wottle/lisa-mouse-logitech-m185/README.md

# Lisa Mouse — Logitech M185 conversion

A 3D-printed shell that turns a **Logitech M185** wireless mouse into a replica of the
**Apple Lisa mouse**. The M185's guts (PCB, sensor, switches, scroll wheel, battery) are
reused; the printed parts replace the stock case. Unlike the original one-button Lisa
mouse, this one has **two buttons**.

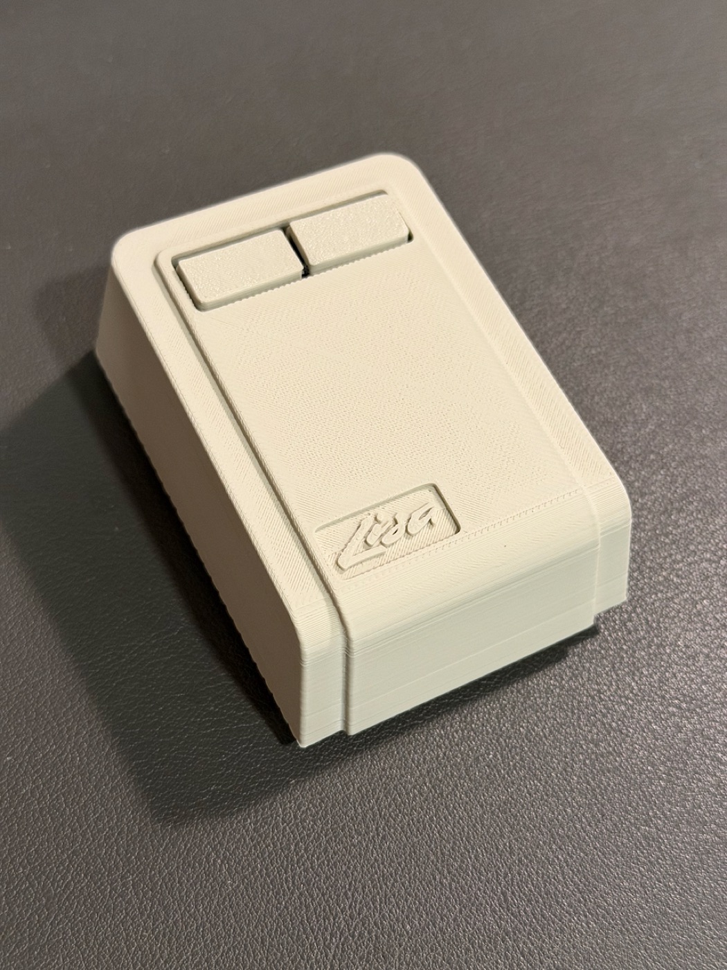
[picture p1: images/assembly/18a_assembly_complete_lisa_logo.jpg]
The finished Lisa Mouse, Lisa logo version


## What you need

| Item | Notes |
|---|---|
| **Genuine** Logitech M185 wireless mouse | Donor for the electronics. See the warning below. |
| 3D printer + PLA | Parts fit a 0.4 mm nozzle; see [docs/PRINTING.md](docs/PRINTING.md). |
| Small Phillips screwdriver | For the M185's own screws. |
| 1 × AA battery | Alkaline AA. |
| PTFE mouse slides (optional) | Self-adhesive pads on the underside for smoother gliding; use any you like. |
| M3 screws | 1 × M3×4 flat head (PCB), 2 × M3×6 countersunk (button retainer), 2 × M3×8 countersunk (case); see [docs/ASSEMBLY.md](docs/ASSEMBLY.md). |

> **⚠️ Buy a genuine Logitech M185.** Discount marketplaces (Temu, AliExpress and the like)
> sell knock-off mice made to look like the M185 but with a cheap, incompatible PCB inside.
> The printed parts are designed around the real M185 board and will not work with it.
> Buy from the Amazon Logitech store (or another authorized Logitech seller). Saving a few
> dollars isn't worth ending up with a mouse you can't use.

## Printed parts

STL files are in [`models/`](models/). Dimensions are the bounding box in the model's
design orientation (X × Y × Z, mm).

| File | Qty | Size (mm) | Purpose |
|---|:---:|---|---|
| `base.stl` | 1 | 57.7 × 84.8 × 18.1 | Bottom plate; holds the M185 board and battery. |
| `top_shell.stl` **or** `top_shell_lisa_logo.stl` | 1 | 62.2 × 91.7 × 31.1 | The Lisa-style upper shell. The `_lisa_logo` variant has an embossed "Lisa" wordmark on top; the plain one is smooth (the photos also show it with an Apple logo decal). |
| `left_button.stl` | 1 | 20.1 × 27.1 × 23.9 | Left button. |
| `right_button.stl` | 1 | 23.9 × 27.1 × 19.5 | Right button. |
| `button_stop.stl` | 1 | 35.6 × 16.1 × 3.9 | Retainer plate that holds both buttons in the top shell. |
| `on_off_button.stl` | 1* | 12.0 × 7.2 × 6.0 | Power switch actuator, slides in the base to operate the M185 power switch. |
| `battery_cover_1.stl` | 1 | 14.7 × 53.1 × 8.9 | Battery door (main plate). |
| `battery_cover_2.stl` | 1 | 7.5 × 11.8 × 6.2 | Battery door (latch piece). |

\* The supplied slicer projects print two, one that is slightly taller that fit better for me; only one is used in the build. Use the one that slides better when the PCB is screwed down.

Part previews are in [`images/`](images/).

## Build it

1. **Print** the parts — [docs/PRINTING.md](docs/PRINTING.md)
2. **Assemble** — [docs/ASSEMBLY.md](docs/ASSEMBLY.md)

## Repository layout

```
models/     Print-ready STLs (one per part)
print/      Slicer projects with plate layout, orientation and settings
            (Bambu Studio / Bambu Lab A1, Creality Print / K2 Plus)
docs/       Printing and assembly instructions
images/     Part previews and slicer plate previews
scripts/    build_models.py — regenerates models/ and images/ from the source OBJ/STL export
```

## Credits

This project is a remix of two existing models. Thank you to their creators:

- **Apple Lisa mouse** — the original Lisa mouse model that the outer shell is based on:
  <https://www.thingiverse.com/thing:6547918>
- **Amiga Mouse (Logitech M185)** — the inner mounting for the M185 electronics comes from
  this model: <https://www.printables.com/model/1137373-amiga-mouse-logitech-m185>

The Lisa shell was combined with the Amiga mouse's M185 internal mounting, then modified
into the two-button design in this repository.

<!-- TODO(author): add each original creator's name and the license each model uses. The remix must be licensed compatibly with both (CC BY-NC-SA 4.0 here requires the originals to allow it); adjust LICENSE if not. -->

## License

[CC BY-NC-SA 4.0](LICENSE) — share and adapt with attribution, non-commercially, under the same license.
