wottle/lisa-mouse-logitech-m185/images/base.png

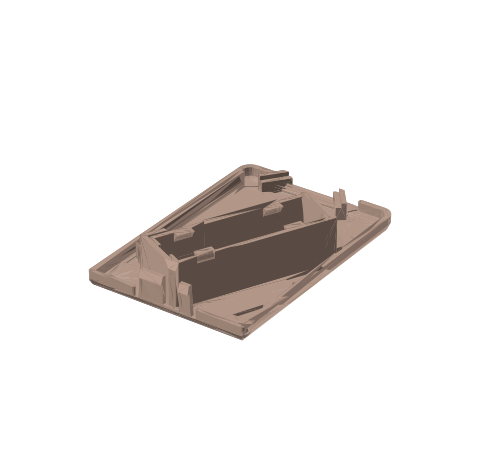
images/base.png
