wottle/lisa-mouse-logitech-m185/images/battery_cover_1.png

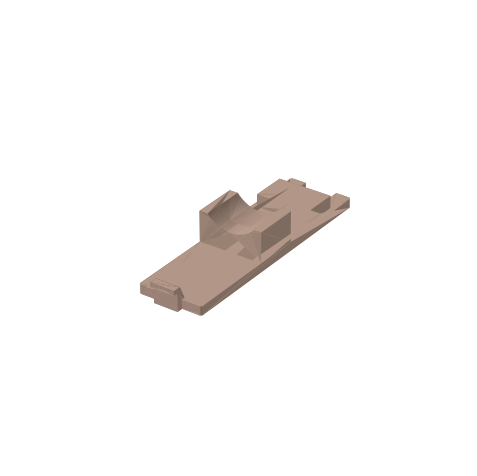
images/battery_cover_1.png
