wottle/lisa-mouse-logitech-m185/images/battery_cover_2.png

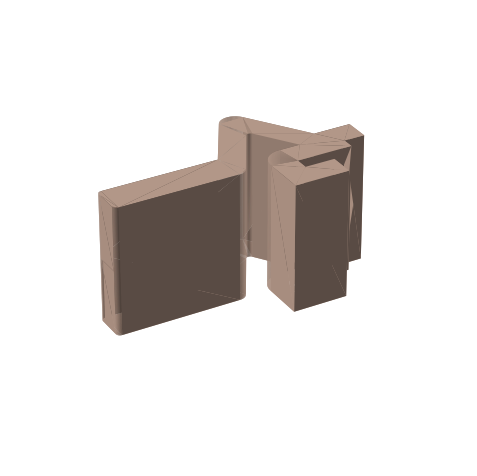
images/battery_cover_2.png
