wottle/lisa-mouse-logitech-m185/images/button_stop.png

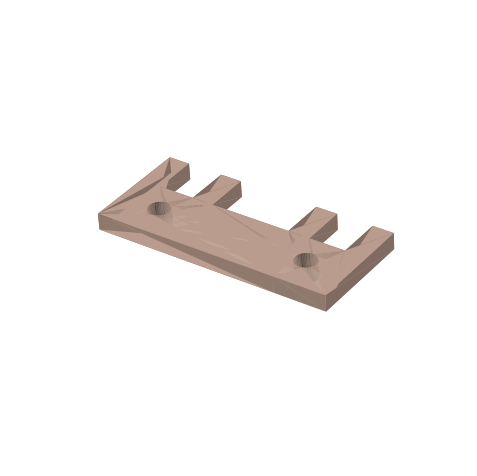
images/button_stop.png
