wottle/lisa-mouse-logitech-m185/images/left_button.png

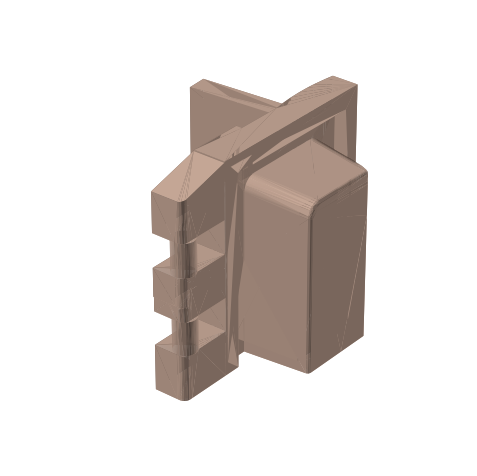
images/left_button.png
