wottle/lisa-mouse-logitech-m185/images/on_off_button.png

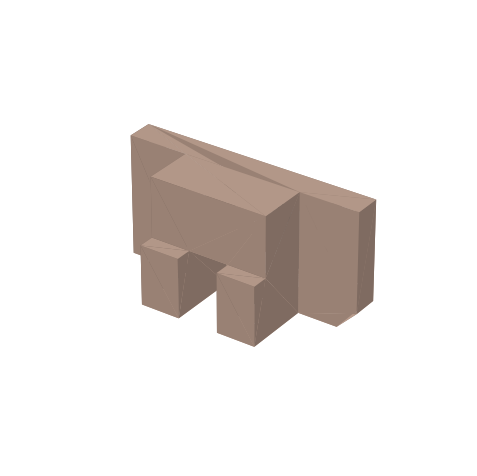
images/on_off_button.png
