wottle/lisa-mouse-logitech-m185/images/plates/bambu_plate_3.png

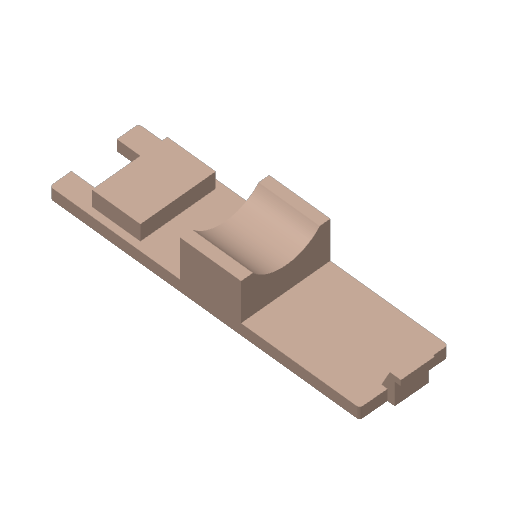
images/plates/bambu_plate_3.png
