wottle/lisa-mouse-logitech-m185/images/plates/creality_plate_3.png

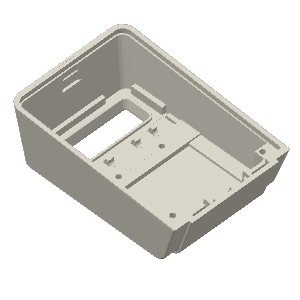
images/plates/creality_plate_3.png
