wottle/lisa-mouse-logitech-m185/images/right_button.png

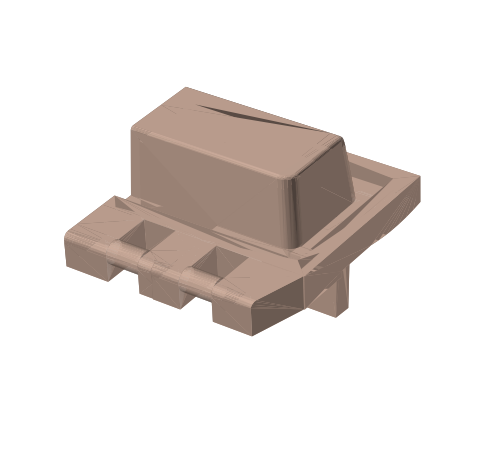
images/right_button.png
