wottle/lisa-mouse-logitech-m185/images/top_shell.png

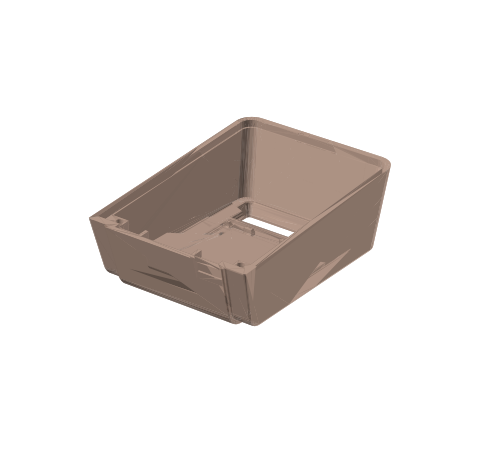
images/top_shell.png
