wottle/lisa-mouse-logitech-m185/models/right_button.stl

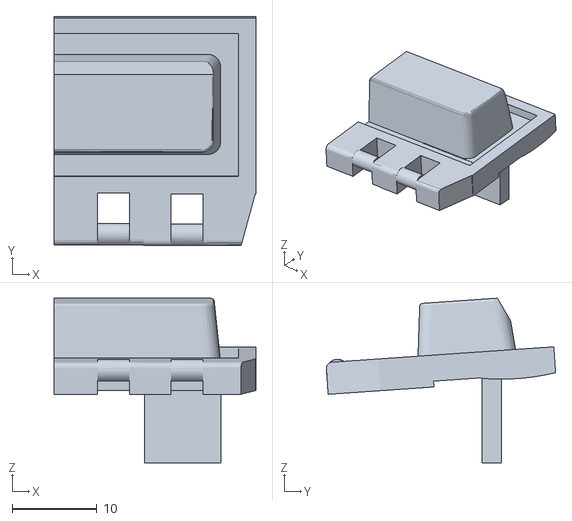
[picture p12: CAD file, 2026-10-30]
models/right_button.stl
23.9 x 27.1 x 19.5
