wottle/lisa-mouse-logitech-m185/print/LisaMouse_BambuStudio_A1.3mf

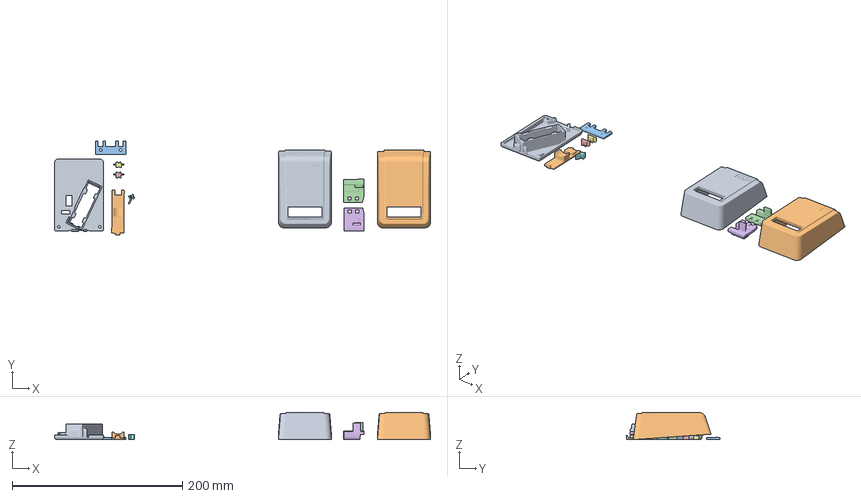
[picture p13: CAD file, 2026-11-01]
print/LisaMouse_BambuStudio_A1.3mf
441.2 x 110.7 x 32.0 mm
LisaMouseLogiechM185_base_v5.obj
Battery_cover_1.stl.stl
LisaMouseLogiechM185_v3_button_stop_v2.obj
LisaMouseLogiechM185_left_button.obj
on-off_button.stl.stl x 2
LisaMouseLogiechM185_right_button.obj
Battery_cover_2.stl.stl
top_shell_lisa_logo.stl
top_shell.stl
