wottle/lisa-mouse-logitech-m185/models/on_off_button.stl

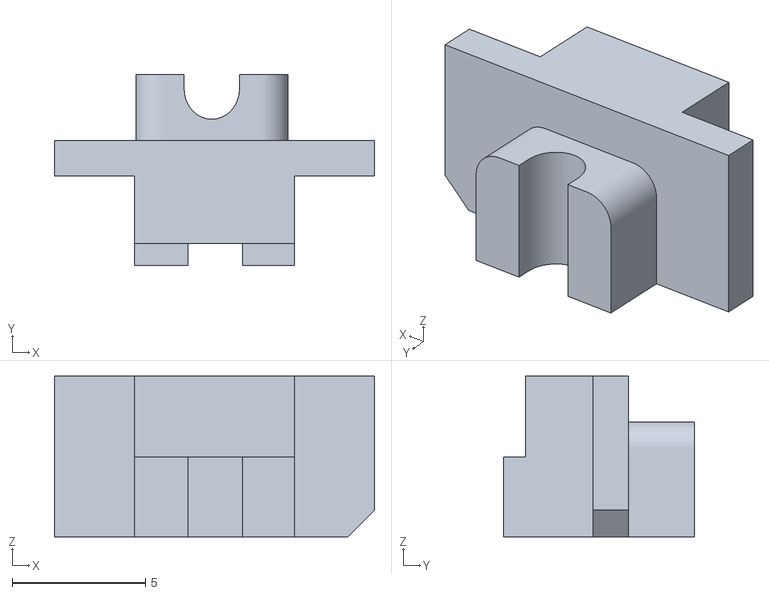
[picture p14: CAD file, 2026-10-30]
models/on_off_button.stl
12.0 x 7.15 x 6.02
