wottle/lisa-mouse-logitech-m185/print/LisaMouse_CrealityPrint_K2Plus.3mf

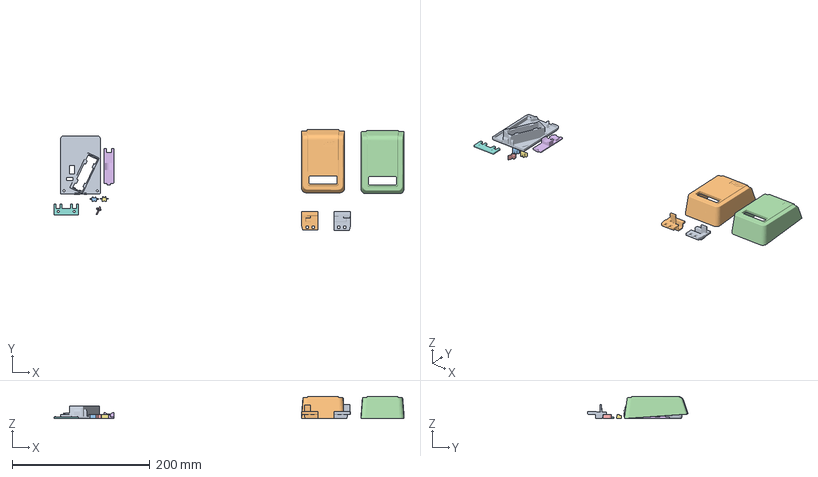
[picture p15: CAD file, 2026-11-01]
print/LisaMouse_CrealityPrint_K2Plus.3mf
507.3 x 145.8 x 32.0 mm
LisaMouseLogiechM185_base_v5.obj
top_shell_lisa_logo.stl
on-off_button.stl.stl x 2
top_shell.stl
Battery_cover_2.stl.stl
Battery_cover_1.stl.stl
LisaMouseLogiechM185_v3_button_stop_v2.obj
left_button.stl
right_button.stl
