wottle/lisa-mouse-logitech-m185/models/battery_cover_1.stl

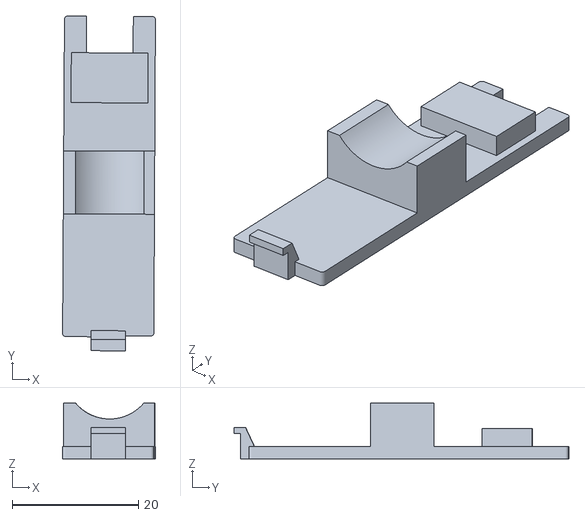
[picture p16: CAD file, 2026-10-30]
models/battery_cover_1.stl
14.7 x 53.1 x 8.86
