wottle/lisa-mouse-logitech-m185/models/button_stop.stl

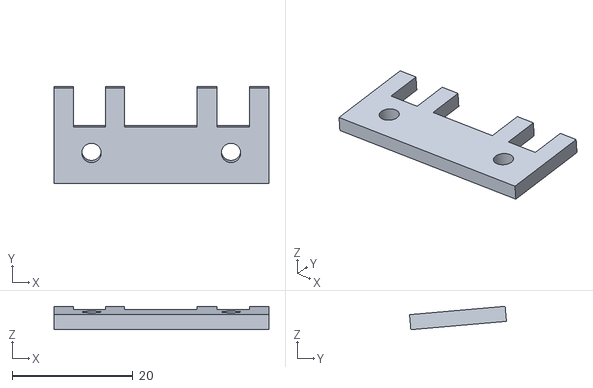
[picture p17: CAD file, 2026-10-30]
models/button_stop.stl
35.6 x 16.1 x 3.88
