wottle/lisa-mouse-logitech-m185/models/top_shell.stl

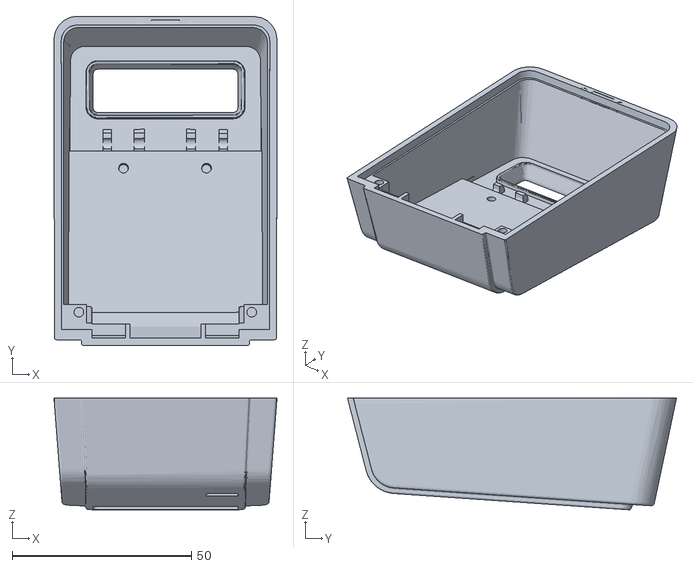
[picture p18: CAD file, 2026-10-30]
models/top_shell.stl
62.2 x 91.7 x 31.1
