wottle/lisa-mouse-logitech-m185/models/left_button.stl

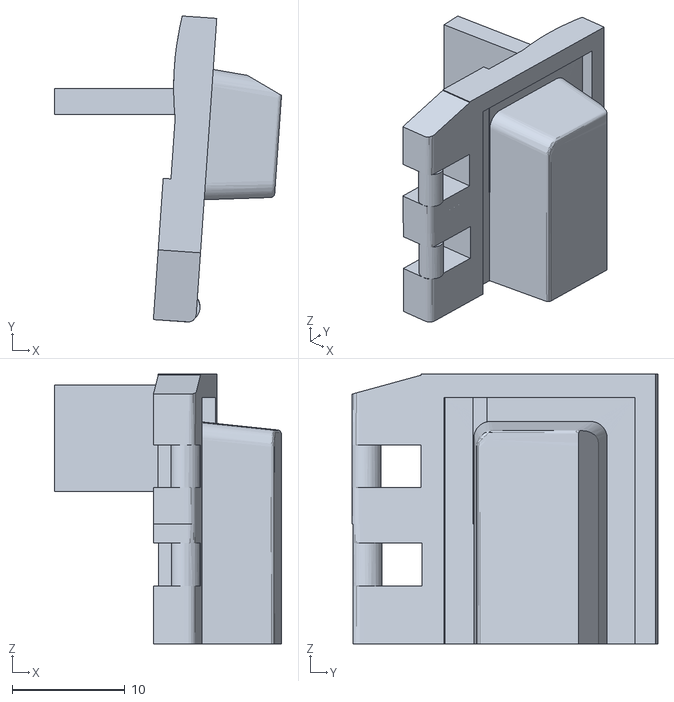
[picture p19: CAD file, 2026-10-30]
models/left_button.stl
20.1 x 27.1 x 23.9
