wottle/lisa-mouse-logitech-m185/models/battery_cover_2.stl

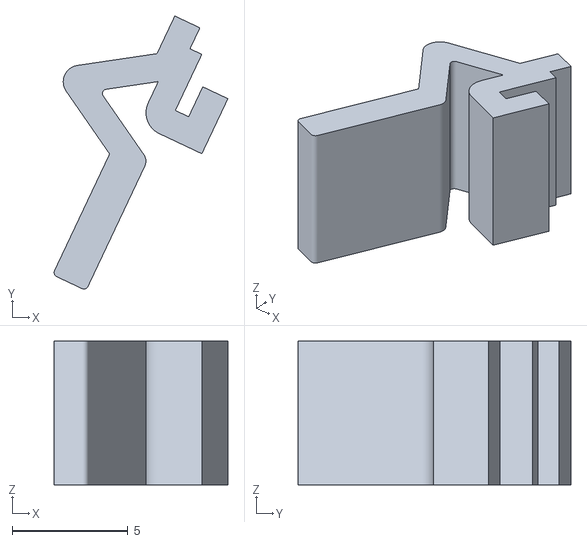
[picture p20: CAD file, 2026-10-30]
models/battery_cover_2.stl
7.51 x 11.8 x 6.20
