wottle/lisa-mouse-logitech-m185/models/base.stl

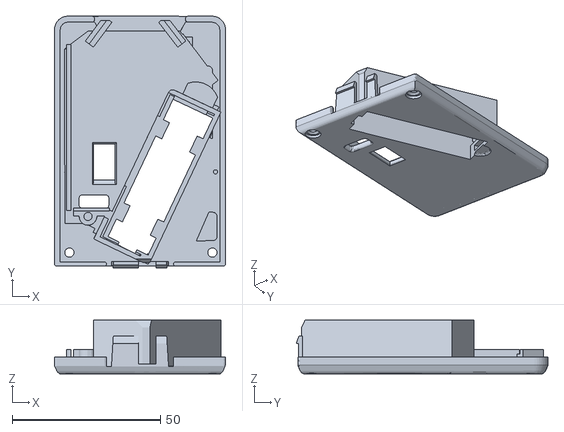
[picture p21: CAD file, 2026-10-30]
models/base.stl
57.6 x 84.8 x 18.1
