wottle/lisa-mouse-logitech-m185/(list of files, cad)

Other CAD files:
models/top_shell_lisa_logo.stl
