wottle/lisa-mouse-logitech-m185/(commit log)

2026-10-30 Initial release: Lisa Mouse shell for Logitech M185
    Print-ready STLs, slicer projects, printing and assembly docs.
    [LisaMouse_BambuStudio_A1.3mf, LisaMouse_CrealityPrint_K2Plus.3mf, base.stl, battery_cover_1.stl, battery_cover_2.stl, button_stop.stl, left_button.stl, on_off_button.stl]
2026-10-30 docs: per-part print orientation, top shell options, resin recommendation
2026-11-01 docs: step-by-step assembly guide with photos
2026-11-01 docs: two-plate print projects (no-support / supports), M3 screw details
    [LisaMouse_BambuStudio_A1.3mf, LisaMouse_CrealityPrint_K2Plus.3mf]
2026-11-01 print: Bambu project updated to v4 top shell; refresh plate previews
    [LisaMouse_BambuStudio_A1.3mf]
2026-11-01 docs: exact M3 screw sizes
2026-11-01 print: standard (auto) supports in both projects; PTFE slides optional
    [LisaMouse_BambuStudio_A1.3mf, LisaMouse_CrealityPrint_K2Plus.3mf]
2026-11-09 docs: warn about counterfeit M185 mice; battery contact wire tip and troubleshooting
